Dharani-Sundharam/4-bit_Calculator/4 - bit Calcuclator/BCD display.jpg

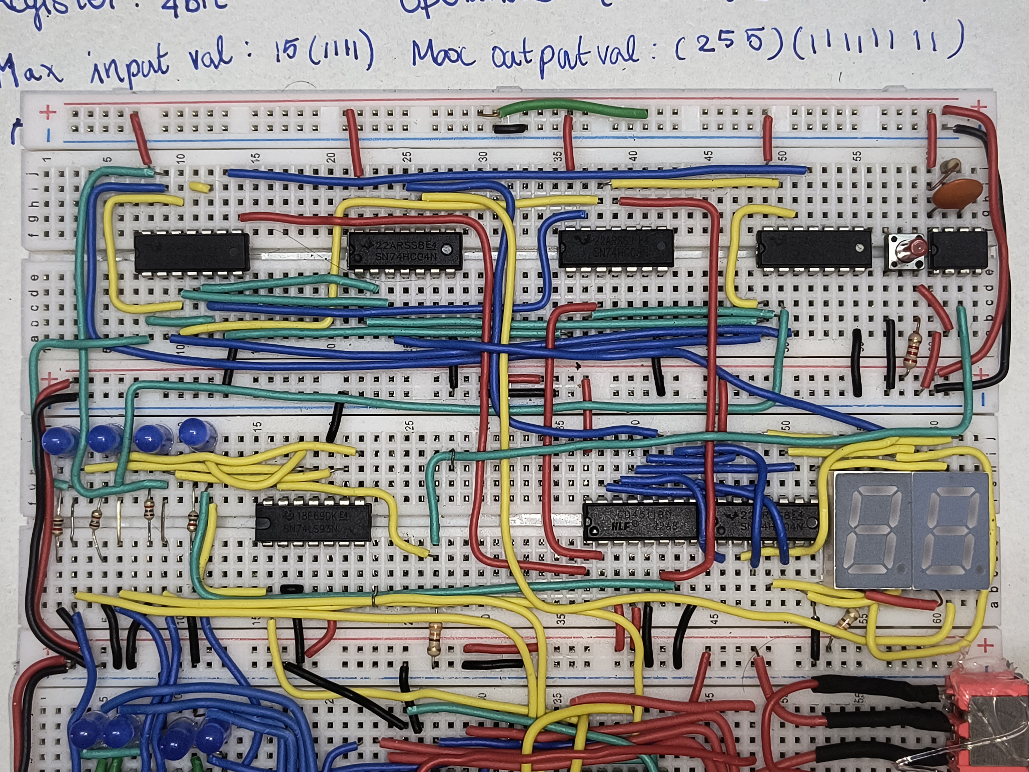
4 - bit Calcuclator/BCD display.jpg
