Dharani-Sundharam/4-bit_Calculator/4 - bit Calcuclator/Full image.jpg

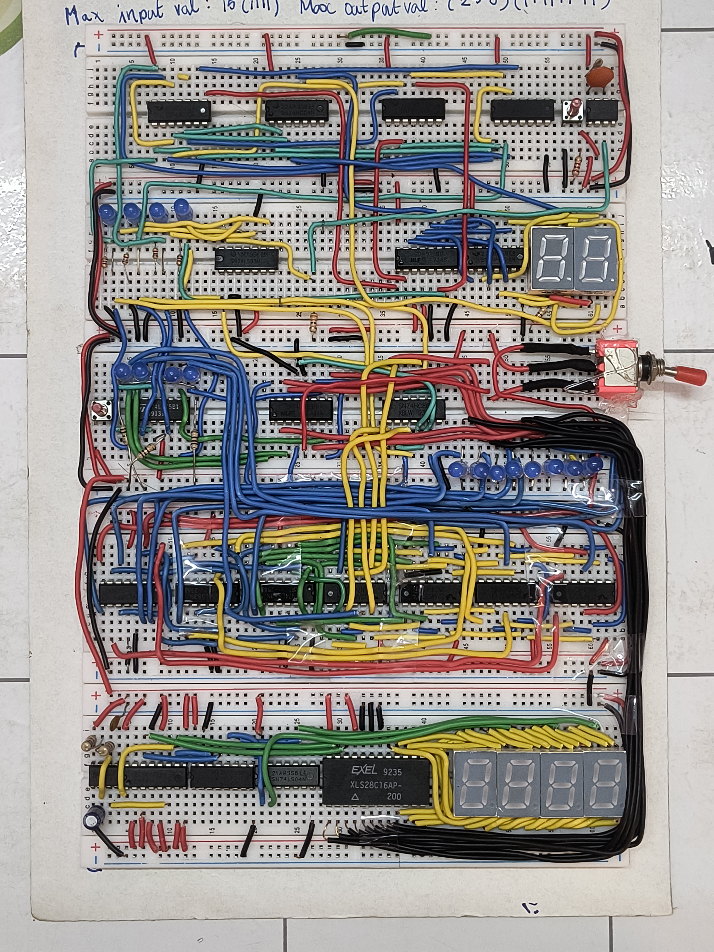
4 - bit Calcuclator/Full image.jpg
