Dharani-Sundharam/4-bit_Calculator/4 - bit Calcuclator/4 - bit BCD.png

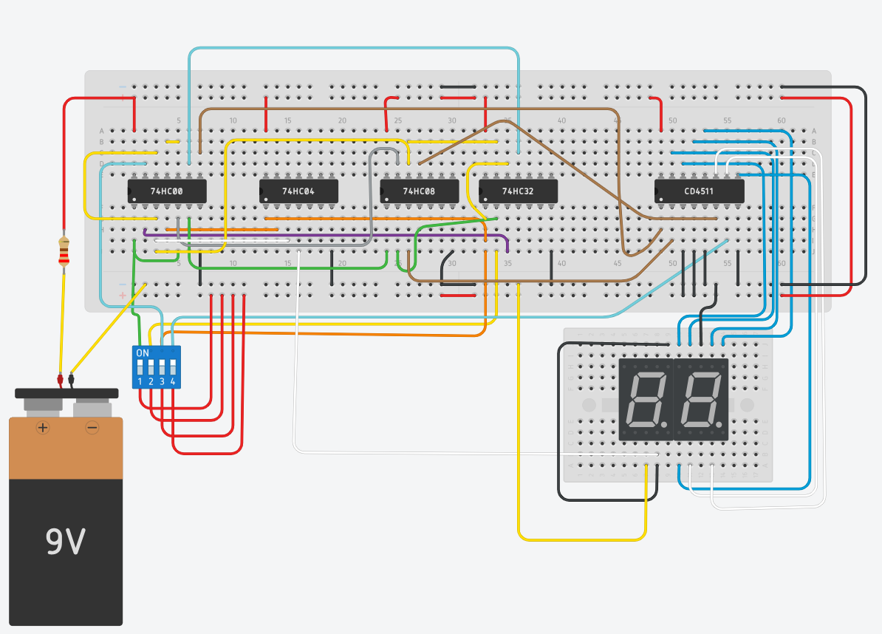
4 - bit Calcuclator/4 - bit BCD.png
