Dharani-Sundharam/4-bit_Calculator/4 - bit Calcuclator/ALU .jpg

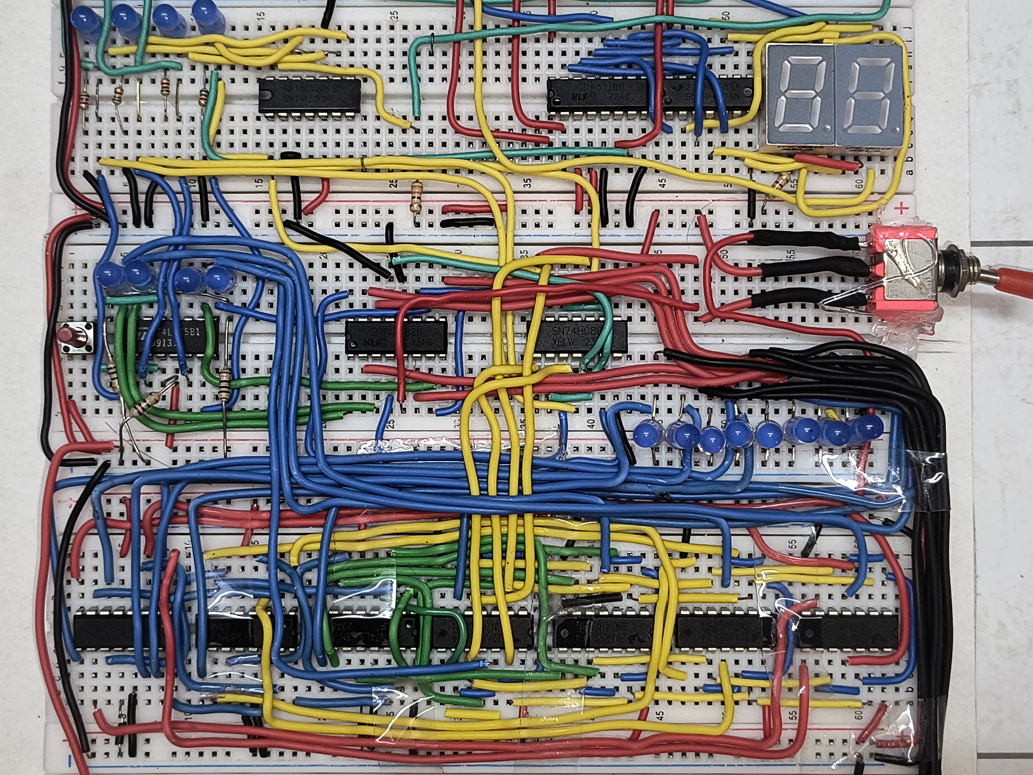
4 - bit Calcuclator/ALU .jpg
