Dharani-Sundharam/4-bit_Calculator/4 - bit Calcuclator/BCD proto.bmp

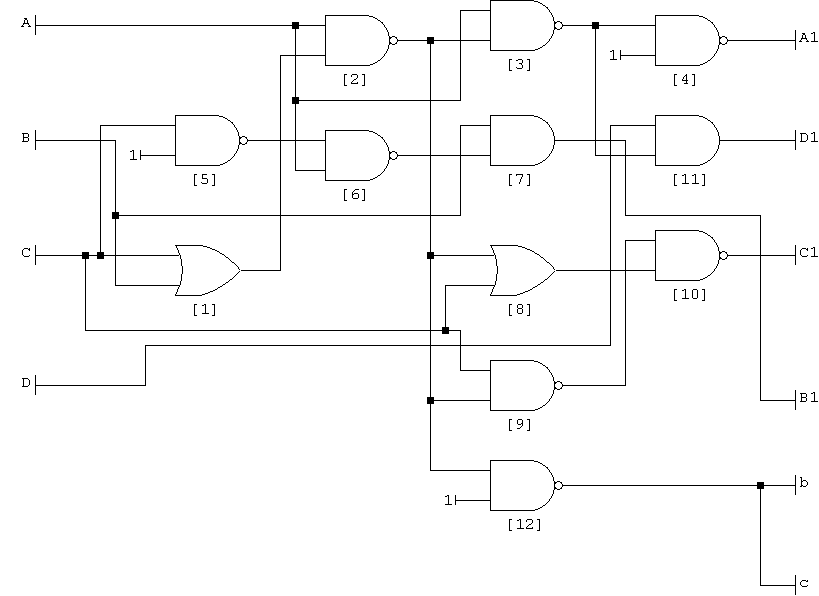
4 - bit Calcuclator/BCD proto.bmp
