Dharani-Sundharam/4-bit_Calculator/4 - bit Calcuclator/g-b2.bmp

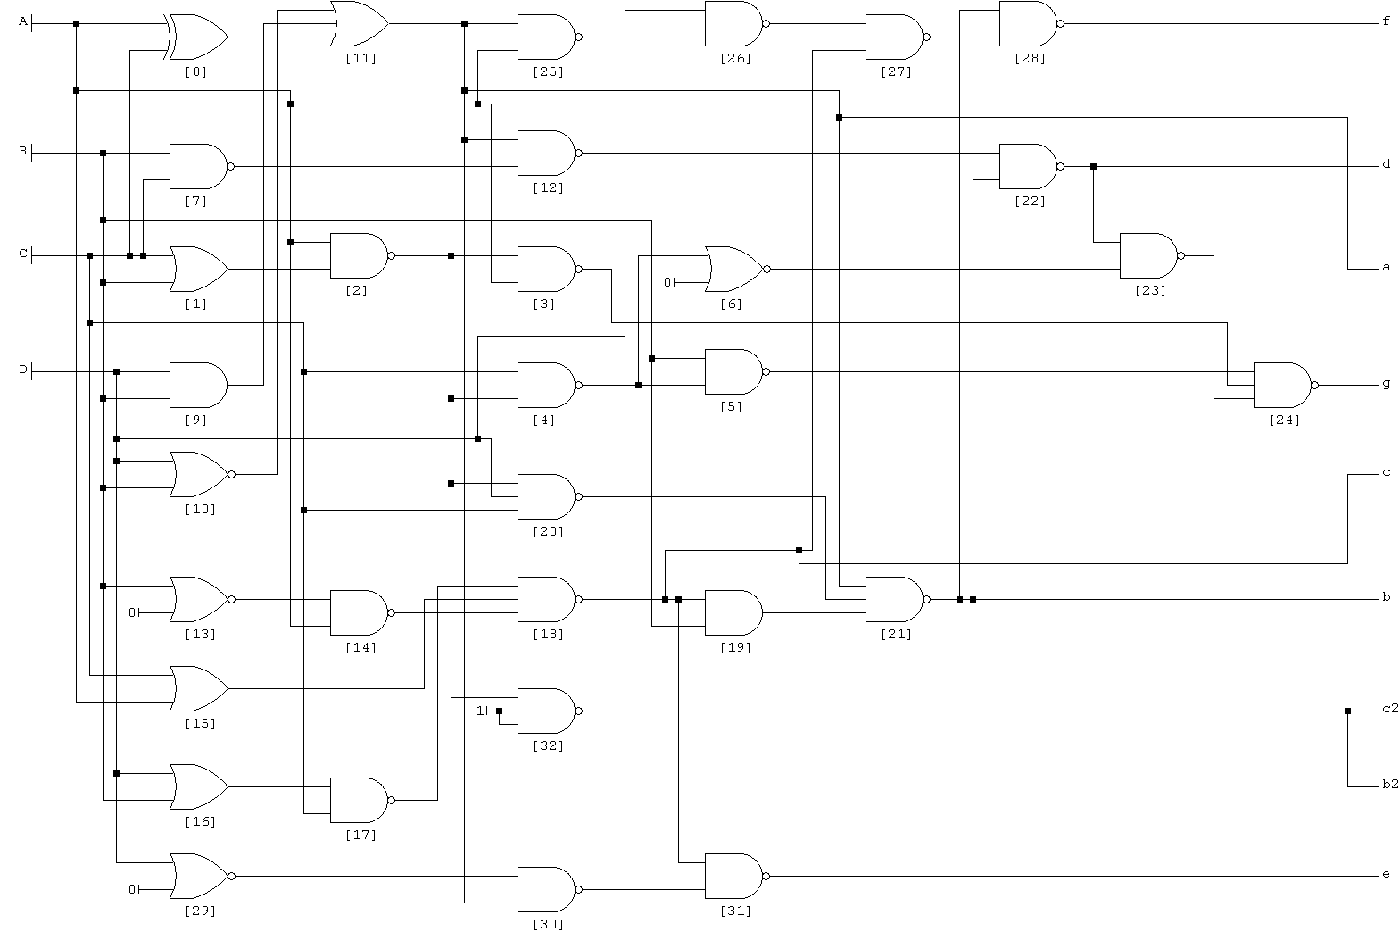
4 - bit Calcuclator/g-b2.bmp
