Dharani-Sundharam/4-bit_Calculator/4 - bit Calcuclator/Multiplication.jpg

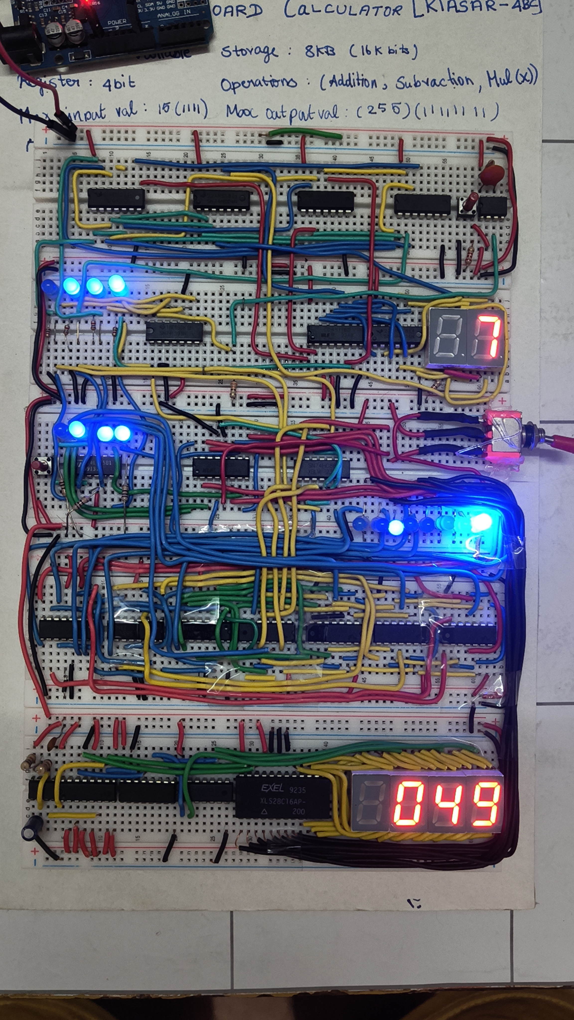
4 - bit Calcuclator/Multiplication.jpg
