Dharani-Sundharam/4-bit_Calculator/4 - bit Calcuclator/Traditional-4-bit-array-multiplier.png

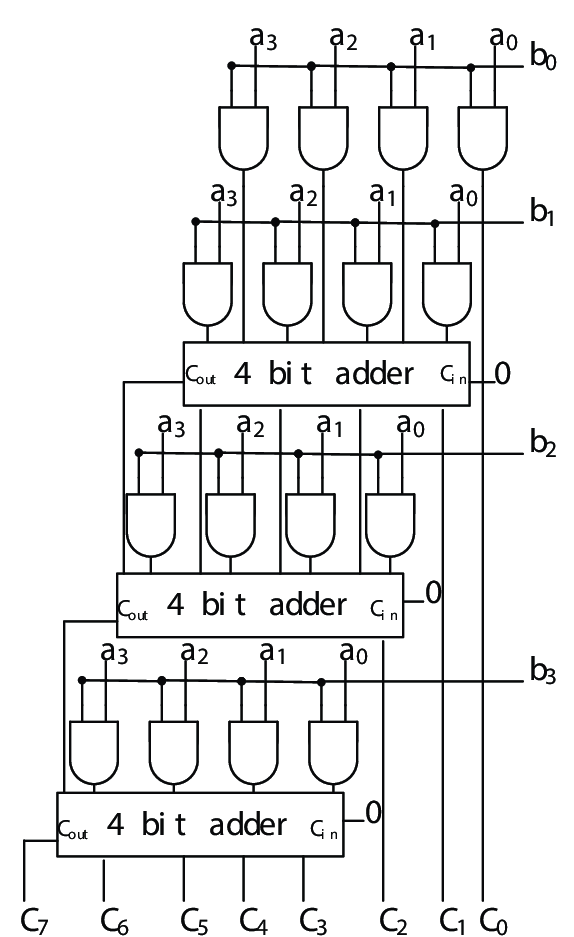
4 - bit Calcuclator/Traditional-4-bit-array-multiplier.png
