Dharani-Sundharam/4-bit_Calculator/4 - bit Calcuclator/4 - bit to BCD.pdf

A

1 | 2 | 3 | 4 | 5 | 6

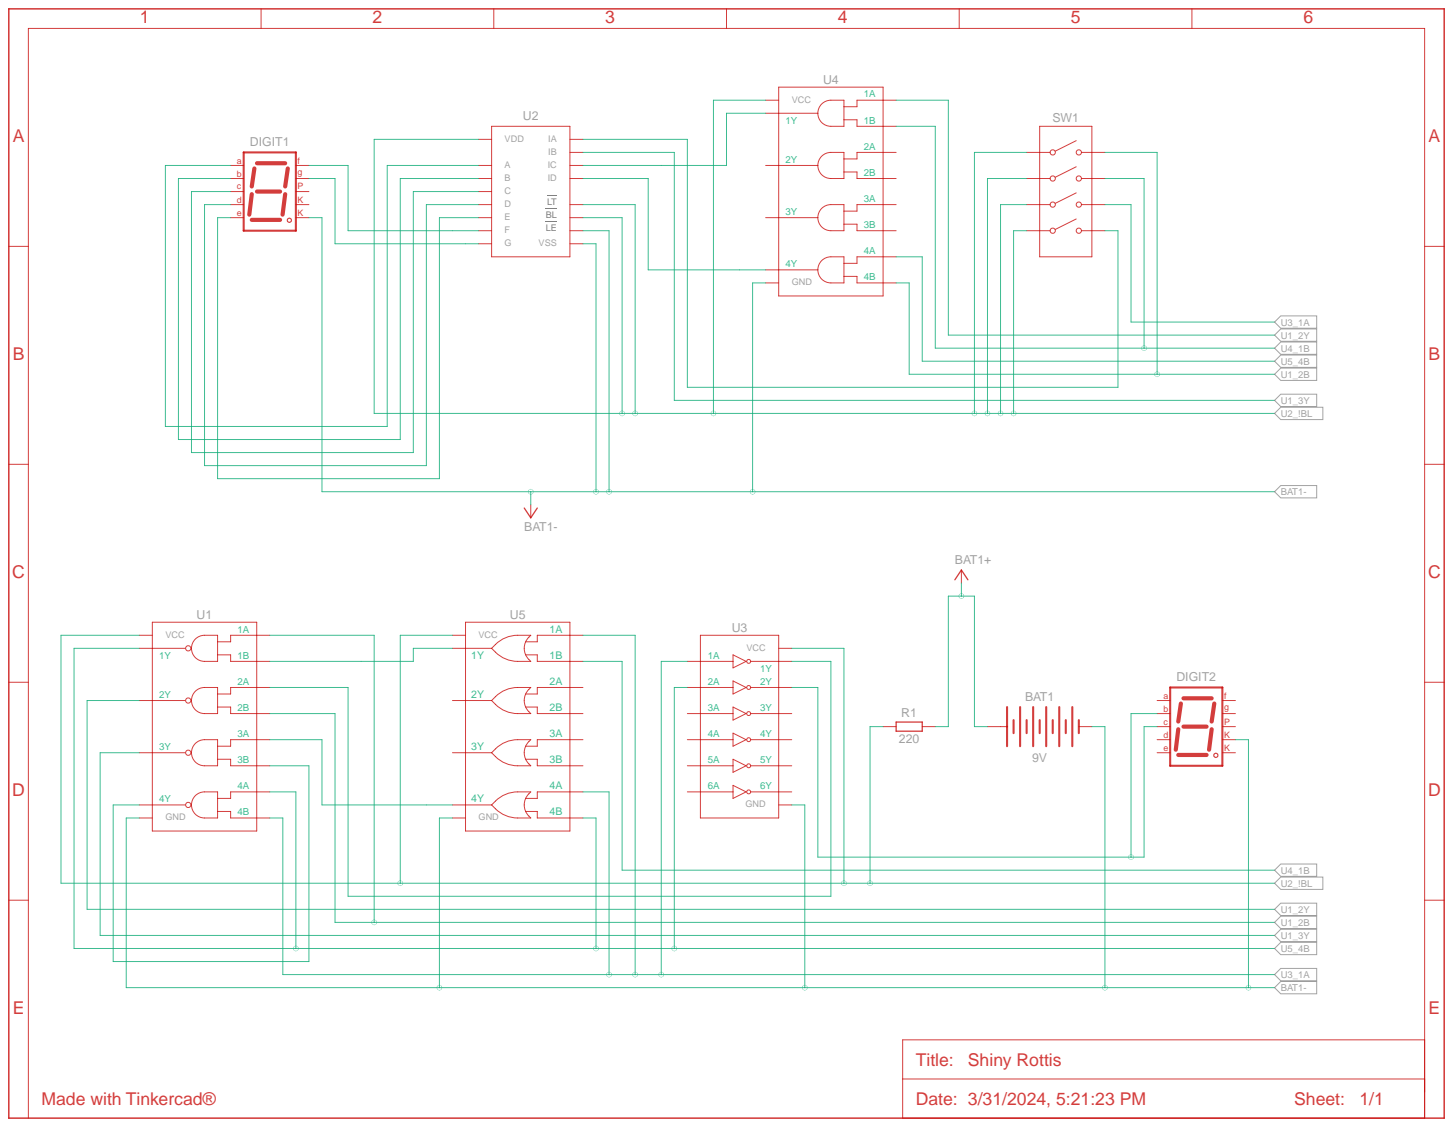
[picture p12: page 1]
Date: 3/31/2024, 5:21:23 PM; Sheet: 1/1; DIGIT1; VDD; VSS; VCC; GND; BAT1-; BAT1; DIGIT2; BAT1+

Title: Shiny Rottis

Made with Tinkercad®
