Dharani-Sundharam/4-bit_Calculator/4 - bit Calcuclator/Addition.jpg

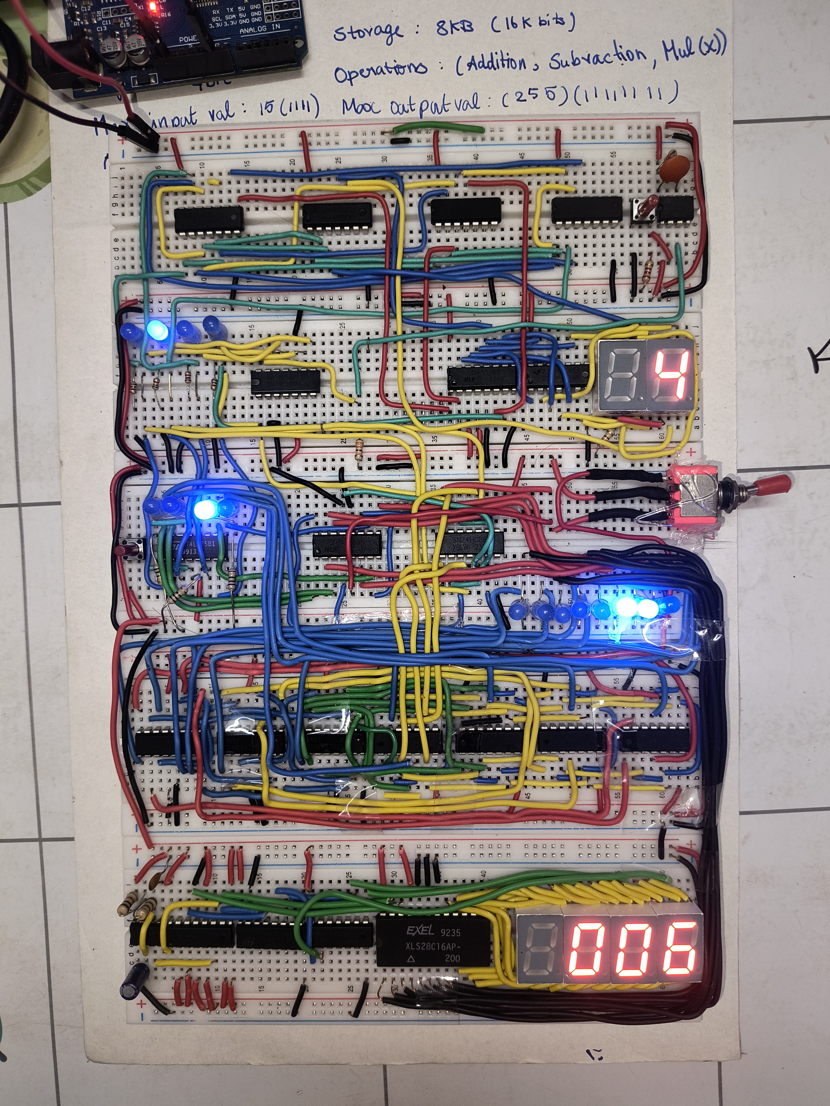
4 - bit Calcuclator/Addition.jpg
